davidmpye/EvokeFlowDisplay/pcb/nt7538/fab/bom.csv

Comment | Designator | Footprint | LCSC | LCSC
1uF | C1,C10,C11,C14,C15,C16,C17,C18,C19 | Capacitor_SMD:C_0805_2012Metric |  | C28323
4.7uF | C13 | Capacitor_SMD:C_0805_2012Metric |  | C1779
10uF | C2 | Capacitor_Tantalum_SMD:CP_EIA-3216-18_Kemet-A |  | C7171
C | C3,C4 | Capacitor_SMD:C_0805_2012Metric |  | C49678
100nF | C9,C5,C6,C7,C8,C12 | Capacitor_SMD:C_0805_2012Metric |  | C49678
CN101 | INPUT_CONN1 | Connector_FFC-FPC:Molex_200528-0080_1x08-1MP_P1.00mm_Horizontal
Conn_01x03_Male | J1 | Connector_PinHeader_2.54mm:PinHeader_1x03_P2.54mm_Vertical
BACKLIGHT_CONN | J2 | Connector_JST:JST_PH_S2B-PH-SM4-TB_1x02-1MP_P2.00mm_Horizontal
SUPP_PWR | J3 | Connector_PinHeader_2.54mm:PinHeader_1x02_P2.54mm_Vertical
Conn_01x30 | LCD_CONN1 | Connector_FFC-FPC:Hirose_FH12-30S-0.5SH_1x30-1MP_P0.50mm_Horizontal
Q_NMOS_GSD | Q1 | Package_TO_SOT_SMD:SOT-23 |  | C347475
10K | R1,R3 | Resistor_SMD:R_0805_2012Metric |  | C17414
1K | R2 | Resistor_SMD:R_0805_2012Metric |  | C17513
200K | R4 | Resistor_SMD:R_0805_2012Metric |  | C17539
Conn_01x05 | ST_LINK1 | Connector_PinHeader_2.54mm:PinHeader_1x05_P2.54mm_Vertical
TestPoint | TP1,TP2,TP3,TP4,TP5,TP6,TP7,TP8 | TestPoint:TestPoint_Pad_D1.0mm
GD32E230C8T6 | U1 | Package_QFP:LQFP-48_7x7mm_P0.5mm |  | C380535
100K | VR_CONTRAST1 | Potentiometer_THT:Potentiometer_Vishay_T73YP_Vertical
