davidmpye/EvokeFlowDisplay/pcb/ssd1325/fab/evoke.csv

Comment | Designator | Footprint | LCSC | LCSC
4.7uF | C1 | Capacitor_Tantalum_SMD:CP_EIA-36-18_Kemet-A |  | C118249
10uF | C11 | Capacitor_SMD:C_0805_2012Metric |  | C15850
4.7uF | C13 | Capacitor_SMD:C_0805_2012Metric |  | C1779
10uF | C2 | Capacitor_Tantalum_SMD:CP_EIA-3216-18_Kemet-A |  | C7171
C | C3,C4 | Capacitor_SMD:C_0805_2012Metric |  | C49678
100nF | C9,C5,C6,C7,C8,C10,C12 | Capacitor_SMD:C_0805_2012Metric |  | C49678
CN101 | INPUT_CONN1 | Connector_FFC-FPC:Molex_200528-0080_1x08-1MP_P1.00mm_Horizontal
Conn_01x03_Male | J1 | Connector_PinHeader_2.54mm:PinHeader_1x03_P2.54mm_Vertical
Conn_01x30 | LCD_CONN1 | Connector_FFC-FPC:Hirose_FH12-30S-0.5SH_1x30-1MP_P0.50mm_Horizontal
10K | R1,R3 | Resistor_SMD:R_0805_2012Metric |  | C17414
1.2M | R2 | Resistor_SMD:R_0805_2012Metric |  | C17380
Conn_01x05 | ST_LINK1 | Connector_PinHeader_2.54mm:PinHeader_1x05_P2.54mm_Vertical
TestPoint | TP1,TP2,TP3,TP4,TP5,TP6,TP7,TP8,TP9,TP10,TP11 | TestPoint:TestPoint_Pad_D1.0mm
GD32E230C8T6 | U1 | Package_QFP:LQFP-48_7x7mm_P0.5mm |  | C380535
