davidmpye/EvokeFlowDisplay/lcd_frame/main_bracket.stl

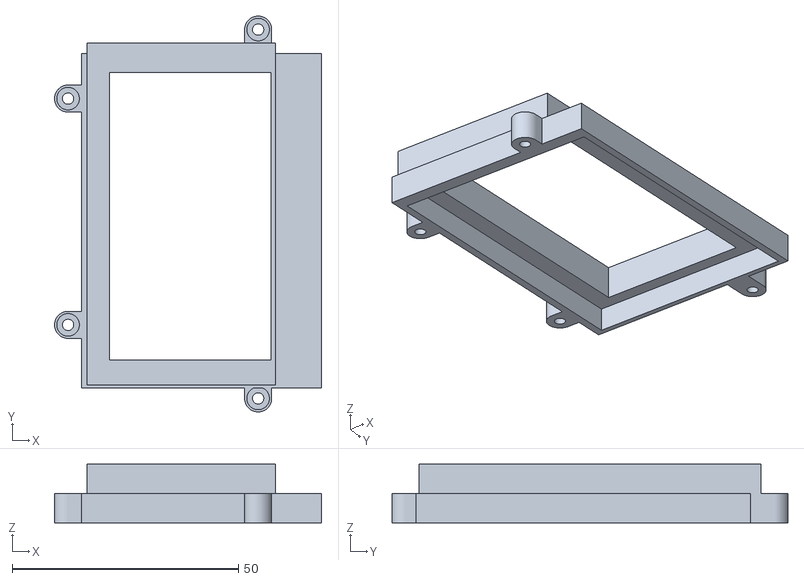
[picture p1: CAD file, 2022-07-04]
lcd_frame/main_bracket.stl
59.0 x 87.5 x 13.0
