davidmpye/EvokeFlowDisplay/lcd_frame/avanti/avanti_lcd_parts.3mf

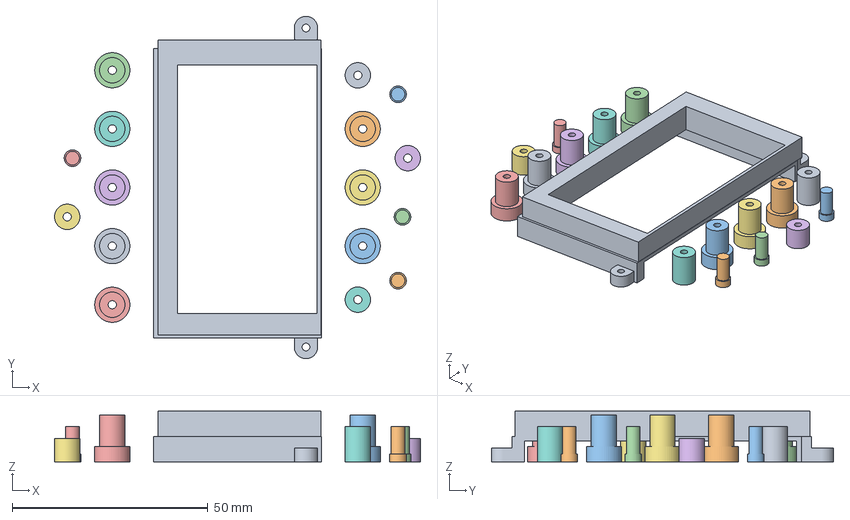
[picture p2: CAD file, 2022-05-02]
lcd_frame/avanti/avanti_lcd_parts.3mf
93.5 x 87.5 x 13.0 mm
avantibracket.stl
button_extx4.stl
collared_standoff_9mmx8.stl
standoff_6mmx2.stl
standoff_9mmx2.stl
