davidmpye/EvokeFlowDisplay/lcd_frame/avanti/collared_standoff_9mmx8.stl

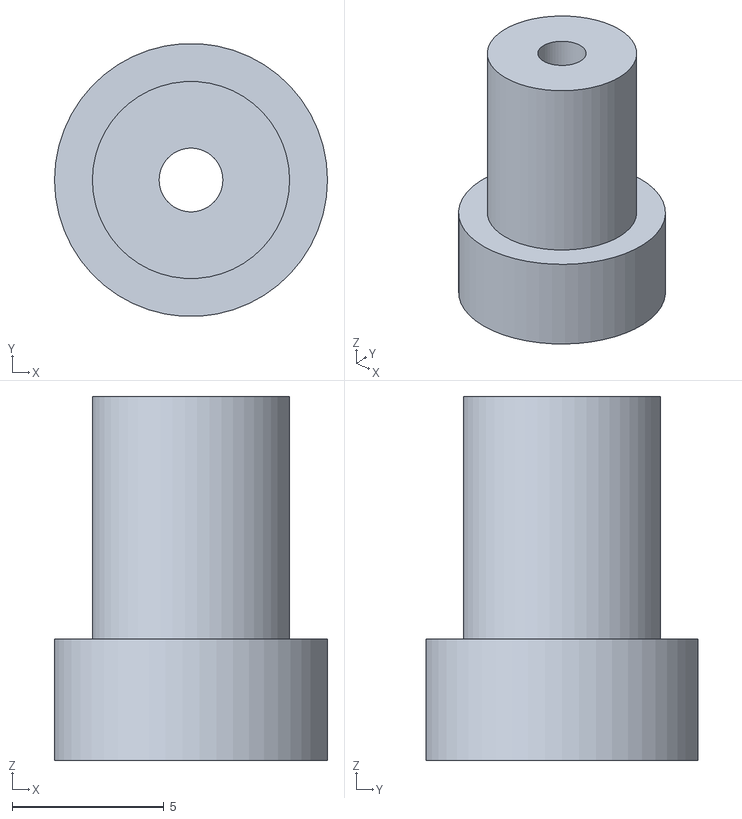
[picture p3: CAD file, 2022-05-02]
lcd_frame/avanti/collared_standoff_9mmx8.stl
9.00 x 8.98 x 12.0
