davidmpye/EvokeFlowDisplay/lcd_frame/avanti/avantibracket.stl

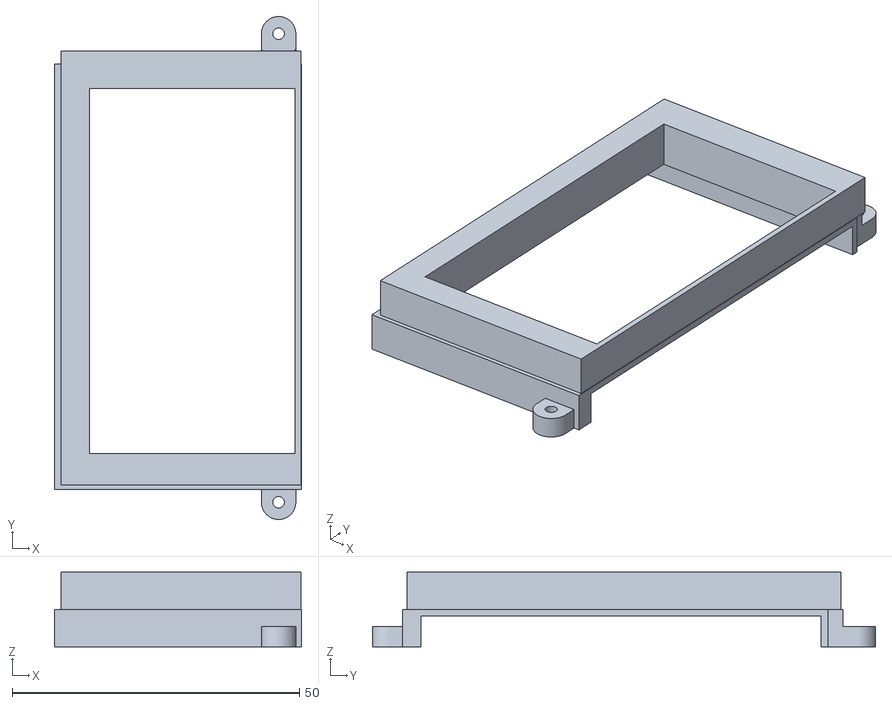
[picture p4: CAD file, 2022-05-02]
lcd_frame/avanti/avantibracket.stl
43.0 x 87.5 x 13.0
