davidmpye/EvokeFlowDisplay/lcd_frame/f4_bracket.stl

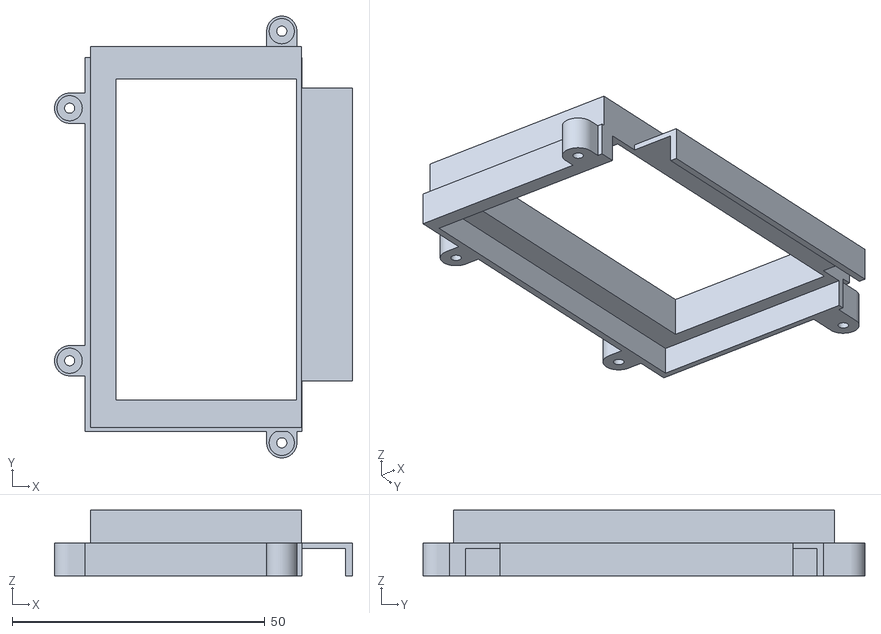
[picture p5: CAD file, 2022-04-24]
lcd_frame/f4_bracket.stl
59.0 x 87.5 x 13.0
