davidmpye/EvokeFlowDisplay/lcd_frame/avanti/standoff_6mmx2.stl

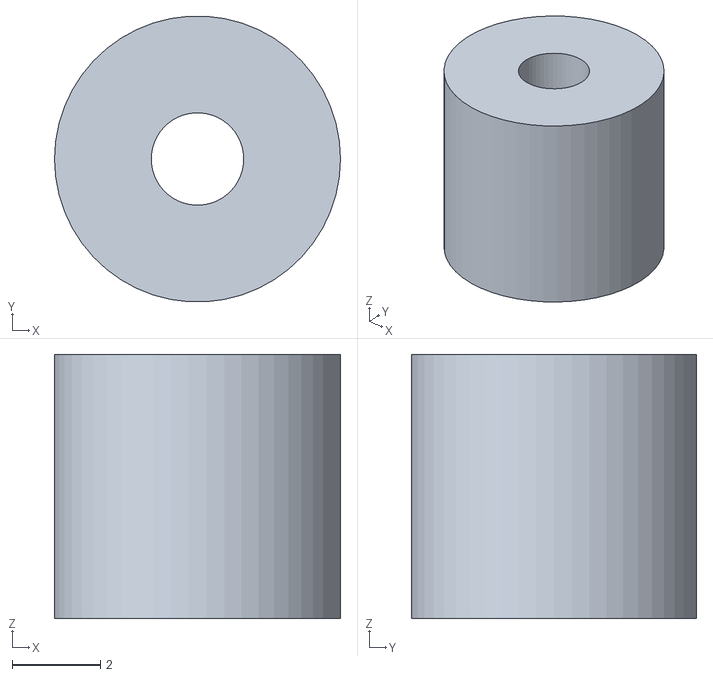
[picture p6: CAD file, 2022-05-02]
lcd_frame/avanti/standoff_6mmx2.stl
6.50 x 6.49 x 6.00
