davidmpye/EvokeFlowDisplay/lcd_frame/avanti/button_extx4.stl

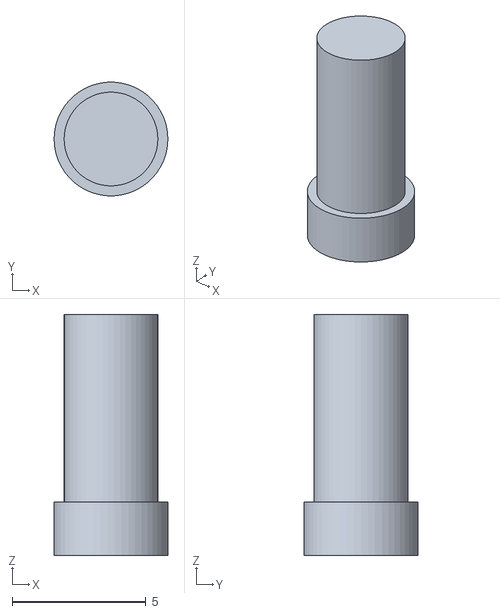
[picture p7: CAD file, 2022-05-02]
lcd_frame/avanti/button_extx4.stl
4.25 x 4.24 x 9.00
