davidmpye/EvokeFlowDisplay/lcd_frame/avanti/standoff_9mmx2.stl

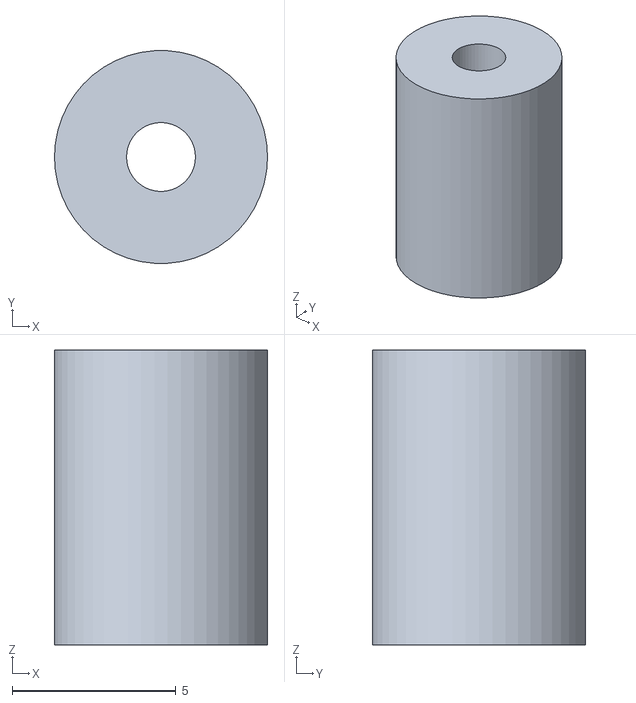
[picture p8: CAD file, 2022-05-02]
lcd_frame/avanti/standoff_9mmx2.stl
6.50 x 6.49 x 9.00
