davidmpye/EvokeFlowDisplay/(list of files, cad)

Other CAD files:
lcd_frame/bracket.3mf
lcd_frame/avanti/avantibracket.scad
