davidmpye/EvokeFlowDisplay/instructions/LCD/PurePackingSlipLCD.odt

Hi!

Thank you for purchasing this LCD upgrade kit for the Pure Evoke Flow radio.

Fitting instructions can be downloaded from:
http://www.davidmpye. (http://www.davidmpye.com/files/LCDInstructions.pdf)com/files/ (http://www.davidmpye.com/files/LCDInstructions.pdf)LCDInstructions.pdf (http://www.davidmpye.com/files/LCDInstructions.pdf)

(please note the capital letters in the link are important)

Please note: The attached four screws should be used to secure the circuit board/the included plastic bracket – they are just the right length)

davidmpye@gmail.com

David Pye

Hi!

Thank you for purchasing this LCD upgrade kit for the Pure Evoke Flow radio.

Fitting instructions can be downloaded from:
http://www.davidmpye. (http://www.davidmpye.com/files/LCDInstructions.pdf)com/files/ (http://www.davidmpye.com/files/LCDInstructions.pdf)LCDInstructions.pdf (http://www.davidmpye.com/files/LCDInstructions.pdf)

(please note the capital letters in the link are important)

Please note: The attached four screws should be used to secure the circuit board/the included plastic bracket – they are just the right length)

davidmpye@gmail.com

David Pye

Hi!

Thank you for purchasing this LCD upgrade kit for the Pure Evoke Flow radio.

Fitting instructions can be downloaded from:
http://www.davidmpye. (http://www.davidmpye.com/files/LCDInstructions.pdf)com/files/ (http://www.davidmpye.com/files/LCDInstructions.pdf)LCDInstructions.pdf (http://www.davidmpye.com/files/LCDInstructions.pdf)

(please note the capital letters in the link are important)

Please note: The attached four screws should be used to secure the circuit board/the included plastic bracket – they are just the right length)

davidmpye@gmail.com

David Pye

Hi!

Thank you for purchasing this LCD upgrade kit for the Pure Evoke Flow radio.

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

(please note the capital letters in the link are important)

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

davidmpye@gmail.com

David Pye
