davidmpye/EvokeFlowDisplay/instructions/OLED/PurePackingSlipOLED25b.odt

Hi!

Thank you for purchasing this OLED replacement kit for the Pure Evoke Flow radio.

Fitting instructions can be downloaded from:
http://www.davidmpye. (http://www.davidmpye.com/files/oled25.pdf)com/files/oled25 (http://www.davidmpye.com/files/oled25.pdf)b (http://www.davidmpye.com/files/oled25.pdf).pdf (http://www.davidmpye.com/files/oled25.pdf)

Please note: If you have fitted one of these kits before, the installation instructions have changed. Please check the instructions.

The attached two screws should be used to secure the circuit board in the kit to the screen bracket, instead of the original screws, as they are slightly longer.

davidmpye@gmail.com

David Pye

Hi!

Thank you for purchasing this OLED replacement kit for the Pure Evoke Flow radio.

Fitting instructions can be downloaded from:
http://www.davidmpye. (http://www.davidmpye.com/files/oled25b.pdf)com/files/oled25 (http://www.davidmpye.com/files/oled25b.pdf)b (http://www.davidmpye.com/files/oled25b.pdf).pdf (http://www.davidmpye.com/files/oled25b.pdf)

Please note: If you have fitted one of these kits before, the installation instructions have changed. Please check the instructions.

The attached two screws should be used to secure the circuit board in the kit to the screen bracket, instead of the original screws, as they are slightly longer.

davidmpye@gmail.com

David Pye

Hi!

Thank you for purchasing this OLED replacement kit for the Pure Evoke Flow radio.

Fitting instructions can be downloaded from:
http://www.davidmpye. (http://www.davidmpye.com/files/oled25.pdf)com/files/oled25 (http://www.davidmpye.com/files/oled25.pdf)b (http://www.davidmpye.com/files/oled25.pdf).pdf (http://www.davidmpye.com/files/oled25.pdf)

Please note: If you have fitted one of these kits before, the installation instructions have changed. Please check the instructions.

The attached two screws should be used to secure the circuit board in the kit to the screen bracket, instead of the original screws, as they are slightly longer.

davidmpye@gmail.com

David Pye
