davidmpye/EvokeFlowDisplay/pcb/ssd1325/evoke.kicad_pcb

## KiCad design pcb/ssd1325/evoke.kicad_pcb (2021-06-09)

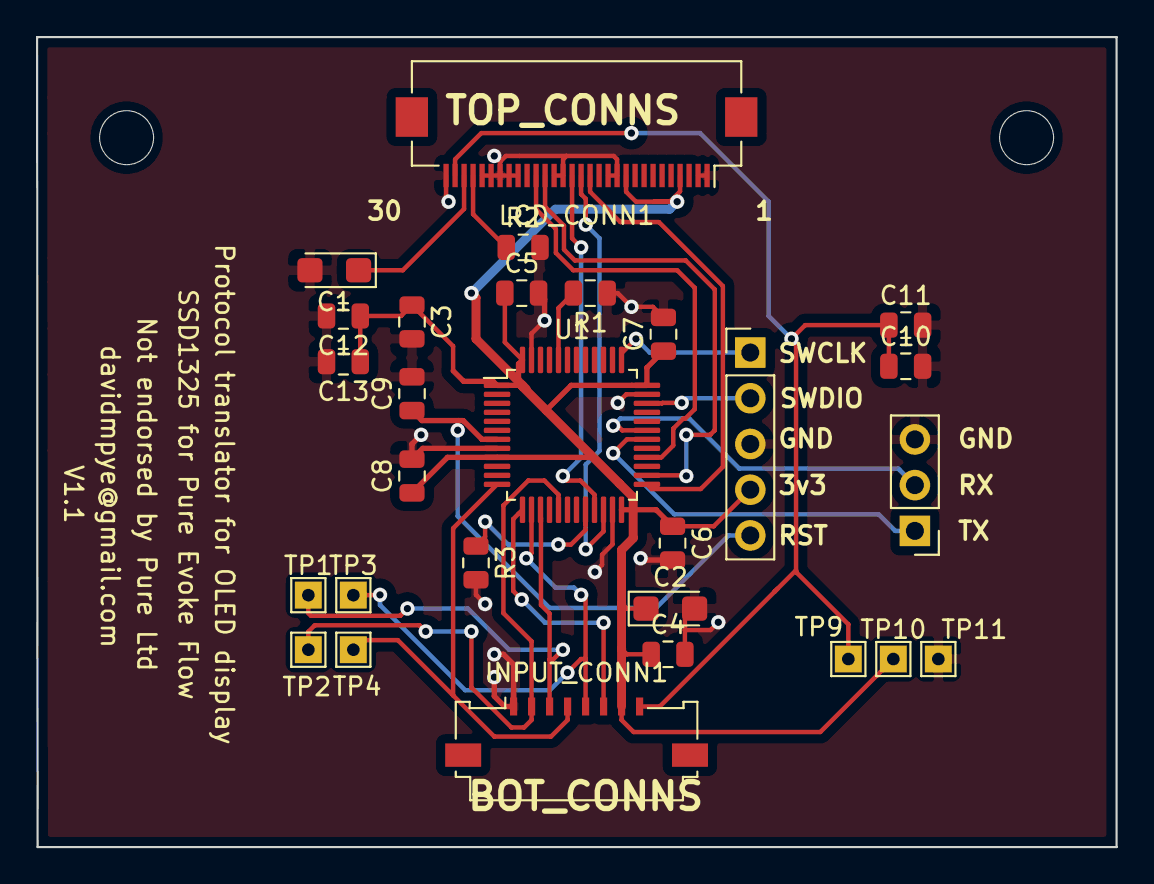
[picture p43: board pcb/ssd1325/evoke.kicad_pcb from above]

Board: 2 copper layers, 60.0 x 45.0 mm, 28 parts (0 on the bottom side), 22 nets.

Parts:
C1: 4.7uF; CP_EIA-3216-18_Kemet-A
C2: 10uF; CP_EIA-3216-18_Kemet-A
C3, C4: C; C_0805_2012Metric
C5, C6, C7, C8, C9, C10, C12: 100nF; C_0805_2012Metric
C11: 10uF; C_0805_2012Metric
C13: 4.7uF; C_0805_2012Metric
INPUT_CONN1: CN101; Molex_200528-0080_1x08-1MP_P1.00mm_Horizontal
J1: Conn_01x03_Male; PinHeader_1x03_P2.54mm_Vertical
LCD_CONN1: Conn_01x30; Hirose_FH12-30S-0.5SH_1x30-1MP_P0.50mm_Horizontal
R1, R3: 10K; R_0805_2012Metric
R2: 1.2M; R_0805_2012Metric
ST_LINK1: Conn_01x05; PinHeader_1x05_P2.54mm_Vertical
TP1, TP2, TP3, TP4, TP9, TP10, TP11: TestPoint; TestPoint_THTPad_1.5x1.5mm_Drill0.7mm
U1: STM32F103C8Tx; LQFP-48_7x7mm_P0.5mm

Connections:
+3V3: C2.1, C3.1, C4.1, C5.1, C6.1, C7.1, C8.1, C12.1, C13.1, INPUT_CONN1.7, LCD_CONN1.4, LCD_CONN1.10, ST_LINK1.4, TP10.1, U1.1, U1.9, U1.24, U1.36, U1.48
CS_IN: INPUT_CONN1.5, TP3.1, U1.14
D_C_IN: INPUT_CONN1.4, TP4.1, U1.12
GND: C1.2, C2.2, C3.2, C4.2, C5.2, C6.2, C7.2, C8.2, C9.2, C10.2, C11.2, C12.2, C13.2, INPUT_CONN1.1, J1.3, LCD_CONN1.1, LCD_CONN1.2, LCD_CONN1.11, LCD_CONN1.12, LCD_CONN1.17, LCD_CONN1.18, LCD_CONN1.22, LCD_CONN1.23, LCD_CONN1.24, LCD_CONN1.25, LCD_CONN1.26, LCD_CONN1.30, R1.1, R2.2, R3.2, ST_LINK1.3, TP11.1, U1.8, U1.23, U1.35, U1.47
LCD_CS: LCD_CONN1.14, U1.25
LCD_DATA: LCD_CONN1.20, U1.28
LCD_D_C: LCD_CONN1.16, U1.21
LCD_RST: LCD_CONN1.15, U1.22
LCD_SCK: LCD_CONN1.19, U1.26
unnamed: C1.1, LCD_CONN1.28
unnamed: LCD_CONN1.27, R2.1
unnamed: R1.2, U1.44
unnamed: R3.1, U1.20
RESET: C9.1, ST_LINK1.5, U1.7
RST_IN: INPUT_CONN1.6, U1.13
SCK_IN: INPUT_CONN1.3, TP1.1, U1.15
SDIN_IN: INPUT_CONN1.2, TP2.1, U1.17
SWCLK: ST_LINK1.1, U1.37
SWDIO: ST_LINK1.2, U1.34
USART1_RX: J1.2, U1.31
USART1_TX: J1.1, U1.30
VCC: C10.1, C11.1, INPUT_CONN1.8, LCD_CONN1.29, TP9.1
