davidmpye/EvokeFlowDisplay/pcb/nt7538/evoke.kicad_pcb

## KiCad design pcb/nt7538/evoke.kicad_pcb (2020-08-15, an earlier design)

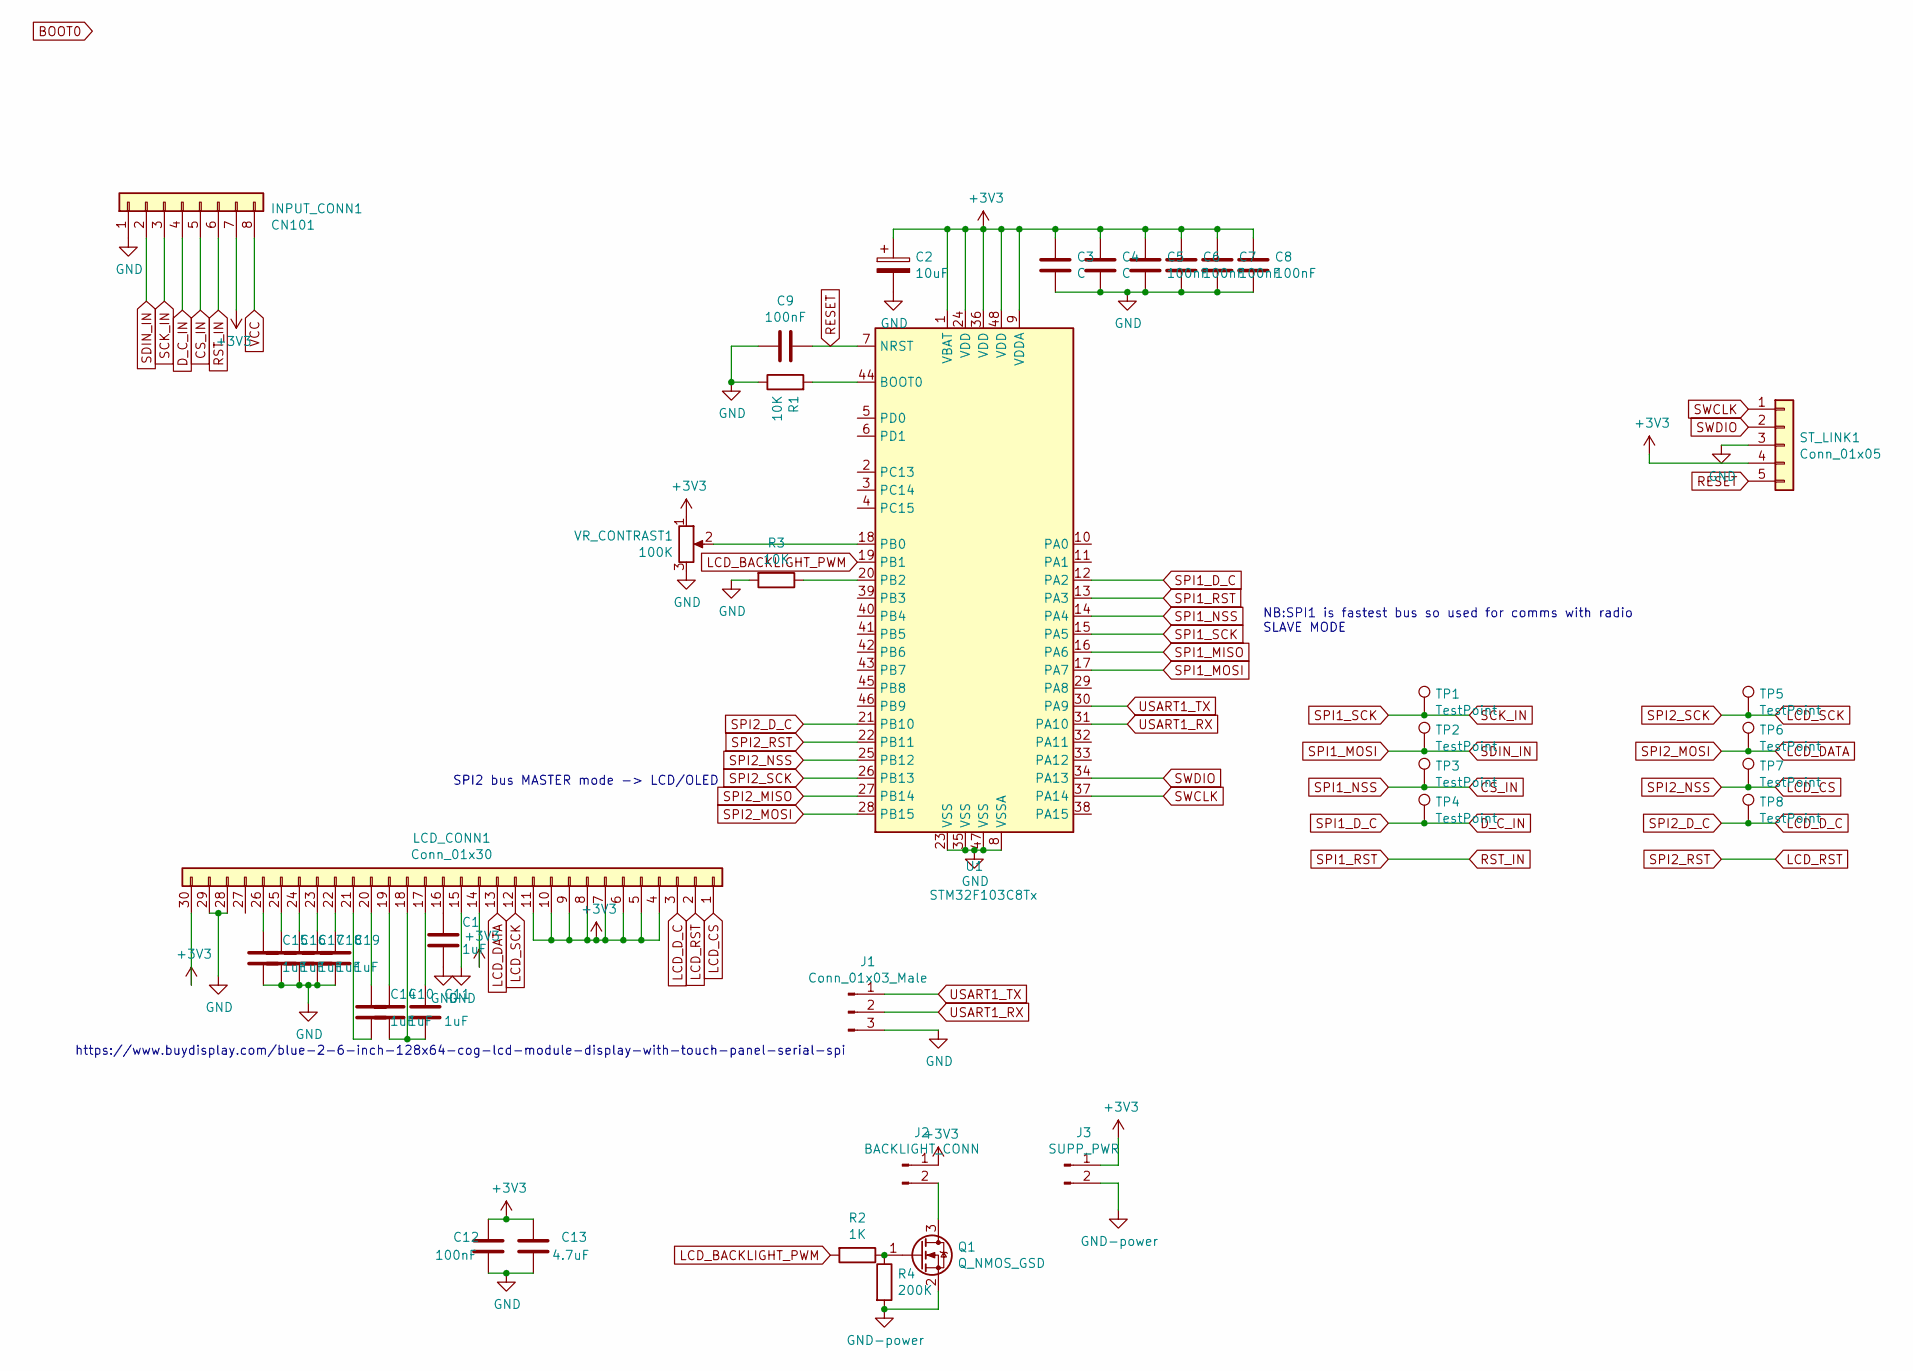
[picture p44: schematic evoke.sch]

Parts:
C1, C10, C11, C14, C15, C16, C17, C18, C19: 1uF; C_0805_2012Metric; LCSC C28323
C2: 10uF; CP_EIA-3216-18_Kemet-A; LCSC C7171
C3, C4: C; C_0805_2012Metric; LCSC C49678
C5, C6, C7, C8, C9, C12: 100nF; C_0805_2012Metric; LCSC C49678
C13: 4.7uF; C_0805_2012Metric; LCSC C1779
INPUT_CONN1: CN101; Molex_200528-0080_1x08-1MP_P1.00mm_Horizontal
J1: Conn_01x03_Male; PinHeader_1x03_P2.54mm_Vertical
J2: BACKLIGHT_CONN; JST_PH_S2B-PH-SM4-TB_1x02-1MP_P2.00mm_Horizontal
J3: SUPP_PWR; PinHeader_1x02_P2.54mm_Vertical
LCD_CONN1: Conn_01x30; Hirose_FH12-30S-0.5SH_1x30-1MP_P0.50mm_Horizontal
Q1: Q_NMOS_GSD; SOT-23; LCSC C347475
R1, R3: 10K; R_0805_2012Metric; LCSC C17414
R2: 1K; R_0805_2012Metric; LCSC C17513
R4: 200K; R_0805_2012Metric; LCSC C17539
ST_LINK1: Conn_01x05; PinHeader_1x05_P2.54mm_Vertical
TP1, TP2, TP3, TP4, TP5, TP6, TP7, TP8: TestPoint; TestPoint_Pad_D1.0mm
U1: STM32F103C8Tx; LQFP-48_7x7mm_P0.5mm; LCSC C8734
VR_CONTRAST1: 100K; Potentiometer_Vishay_T73YP_Vertical

Connections:
+3V3: C2.1, C3.1, C4.1, C5.1, C6.1, C7.1, C8.1, C12.1, C13.1, INPUT_CONN1.7, J2.1, J3.1, LCD_CONN1.4, LCD_CONN1.5, LCD_CONN1.6, LCD_CONN1.7, LCD_CONN1.8, LCD_CONN1.9, LCD_CONN1.10, LCD_CONN1.11, LCD_CONN1.14, LCD_CONN1.30, ST_LINK1.4, U1.1 (VBAT), U1.9 (VDDA), U1.24 (VDD), U1.36 (VDD), U1.48 (VDD), VR_CONTRAST1.1; also elsewhere on the board
CS_IN: INPUT_CONN1.5, TP3.1, U1.14 (PA4); also elsewhere on the board
D_C_IN: INPUT_CONN1.4, TP4.1, U1.12 (PA2); also elsewhere on the board
LCD_BACKLIGHT_PWM: R2.2, U1.19 (PB1)
LCD_CS: LCD_CONN1.1, TP7.1, U1.25 (PB12); also elsewhere on the board
LCD_DATA: LCD_CONN1.13, TP6.1, U1.28 (PB15); also elsewhere on the board
LCD_D_C: LCD_CONN1.3, TP8.1, U1.21 (PB10); also elsewhere on the board
LCD_RST: LCD_CONN1.2, U1.22 (PB11); also elsewhere on the board
LCD_SCK: LCD_CONN1.12, TP5.1, U1.26 (PB13); also elsewhere on the board
unnamed 9: C1.1, LCD_CONN1.16; also elsewhere on the board
unnamed 10: C10.1, LCD_CONN1.19; also elsewhere on the board
unnamed 11: C10.2, C11.2, LCD_CONN1.18; also elsewhere on the board
unnamed 12: C11.1, LCD_CONN1.17; also elsewhere on the board
unnamed 13: C14.1, LCD_CONN1.20; also elsewhere on the board
unnamed 14: C14.2, LCD_CONN1.21; also elsewhere on the board
unnamed 15: C15.1, LCD_CONN1.26; also elsewhere on the board
unnamed 16: C16.1, LCD_CONN1.25; also elsewhere on the board
unnamed 17: C17.1, LCD_CONN1.24; also elsewhere on the board
unnamed 18: C18.1, LCD_CONN1.23; also elsewhere on the board
unnamed 19: C19.1, LCD_CONN1.22; also elsewhere on the board
unnamed: J2.2, Q1.3 (D)
unnamed: Q1.1 (G), R2.1, R4.1
unnamed: R1.2, U1.44 (BOOT0)
unnamed: R3.1, U1.20 (PB2)
unnamed 32: U1.18 (PB0), VR_CONTRAST1.2; also elsewhere on the board
RESET: C9.1, ST_LINK1.5, U1.7 (NRST)
RST_IN: INPUT_CONN1.6, U1.13 (PA3); also elsewhere on the board
SCK_IN: INPUT_CONN1.3, TP1.1, U1.15 (PA5); also elsewhere on the board
SDIN_IN: INPUT_CONN1.2, TP2.1, U1.17 (PA7); also elsewhere on the board
SPI1_MISO: U1.16 (PA6)
SPI2_MISO: U1.27 (PB14)
SWCLK: ST_LINK1.1, U1.37 (PA14)
SWDIO: ST_LINK1.2, U1.34 (PA13)
USART1_RX: J1.2, U1.31 (PA10)
USART1_TX: J1.1, U1.30 (PA9)

Notes on the sheet:
NB:SPI1 is fastest bus so used for comms with radio SLAVE MODE
SPI2 bus MASTER mode -> LCD/OLED
https://www.buydisplay.com/blue-2-6-inch-128x64-cog-lcd-module-display-with-touch-panel-serial-spi

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
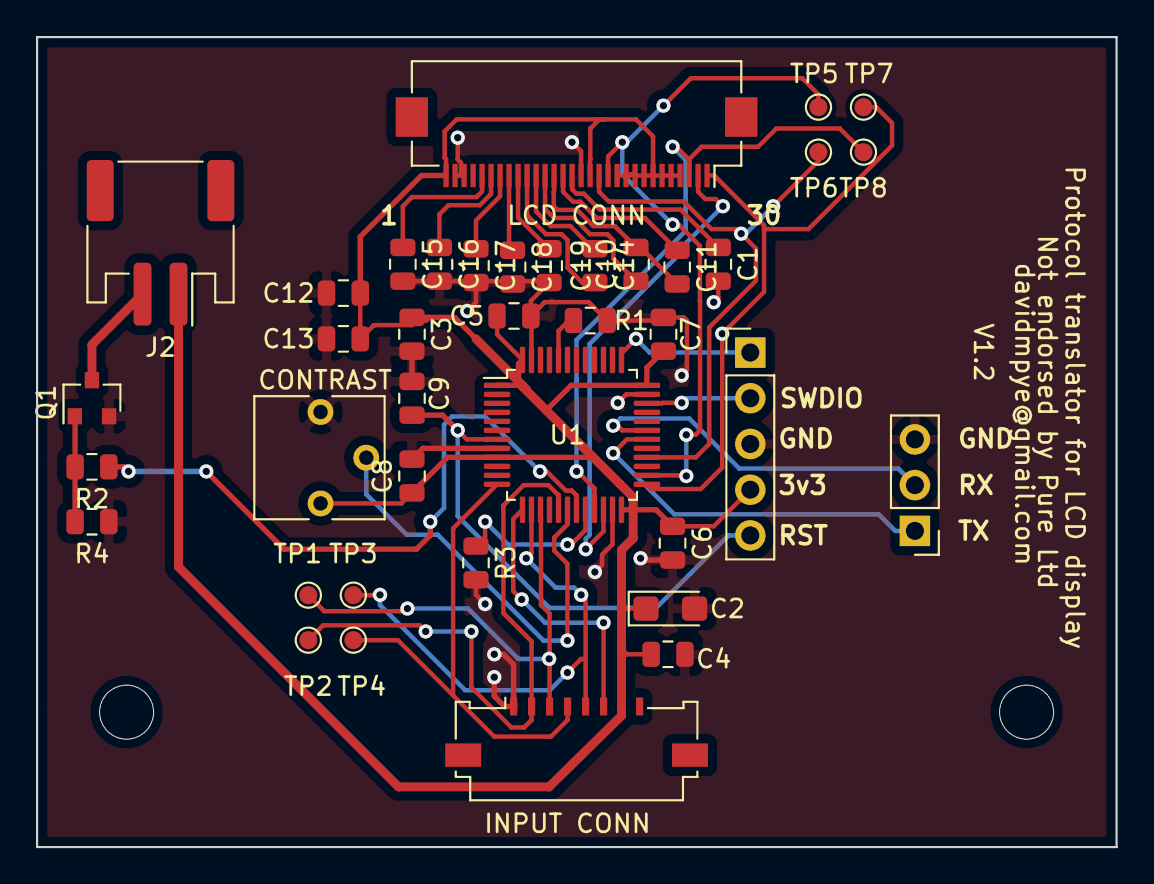
[picture p45: board pcb/nt7538/evoke.kicad_pcb from above]

Board: 2 copper layers, 60.0 x 45.0 mm, 39 parts (0 on the bottom side), 34 nets.

Other parts of the board:
CONTRAST: 100K; Potentiometer_Vishay_T73YP_Vertical
INPUT CONN: CN101; Molex_200528-0080_1x08-1MP_P1.00mm_Horizontal
LCD CONN: Conn_01x30; Hirose_FH12-30S-0.5SH_1x30-1MP_P0.50mm_Horizontal

Their connections:
+3V3: CONTRAST.1, INPUT CONN.7, LCD CONN.4, LCD CONN.5, LCD CONN.6, LCD CONN.7, LCD CONN.8, LCD CONN.9, LCD CONN.10, LCD CONN.11, LCD CONN.14, LCD CONN.30; also elsewhere on the board
CS_IN: INPUT CONN.5; also elsewhere on the board
D_C_IN: INPUT CONN.4; also elsewhere on the board
LCD_CS: LCD CONN.1; also elsewhere on the board
LCD_DATA: LCD CONN.13; also elsewhere on the board
LCD_D_C: LCD CONN.3; also elsewhere on the board
LCD_RST: LCD CONN.2; also elsewhere on the board
LCD_SCK: LCD CONN.12; also elsewhere on the board
unnamed 9: LCD CONN.16; also elsewhere on the board
unnamed 10: LCD CONN.19; also elsewhere on the board
unnamed 11: LCD CONN.18; also elsewhere on the board
unnamed 12: LCD CONN.17; also elsewhere on the board
unnamed 13: LCD CONN.20; also elsewhere on the board
unnamed 14: LCD CONN.21; also elsewhere on the board
unnamed 15: LCD CONN.26; also elsewhere on the board
unnamed 16: LCD CONN.25; also elsewhere on the board
unnamed 17: LCD CONN.24; also elsewhere on the board
unnamed 18: LCD CONN.23; also elsewhere on the board
unnamed 19: LCD CONN.22; also elsewhere on the board
unnamed 32: CONTRAST.2; also elsewhere on the board
RST_IN: INPUT CONN.6; also elsewhere on the board
SCK_IN: INPUT CONN.3; also elsewhere on the board
SDIN_IN: INPUT CONN.2; also elsewhere on the board
