davidmpye/EvokeFlowDisplay/code/ssd1305.c

/*
# Copyright (C) 2020 David Pye davidmpye@gmail.com
# This file is part of the OLED compatibility project targetted at
# Pure Radios Evoke Flow models
#
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
# You should have received a copy of the GNU General Public License
# along with this project.  If not, see <http://www.gnu.org/licenses/>.
*/

#include "ssd1305.h"

#define SSD1305_INIT_CMD_LEN 30
//This is our default block of 'init commands'
uint8_t SSD1305_init_cmds [] = {
	0xAE,   //Display OFF
	0xD5,	//Display clock
	0xF0,	//Display clock oscillator freq
	0xA8,	//Multiplex ratio
	0x3F, 	//Multiplex radio arg
	0xD3,	//Display offset 
	0x40,	//vertical offset//
	0xad,   //External VCC supply (default anyway!)
	0x8e,   //Mandatory (but unspecified) argument to 0xAD!
	0xd8,	//Area colour mode
	0x05,   //monochrome, low power display mode
#ifdef VERTFLIP 
	0xa1,
	0xc8,
#else
	0xa0,
	0xc0, // Change this to c8 if horizontal flip only needed
#endif
	0xda, 	//Hardware com pin configuration
	0x12, 	//'alternative' com pin config, no left to right remap.
	0x91, 	//current drive pulse width
	0x3f, 	//args to above
	0x3f,	//args to above
	0x3f,	//args to above
	0x3f,	//args to above
	0x82,	//Set brightness
	0x80,   //Default brightness
	0xd9,   //Set precharge period
	0xf1,   //was f1 //F = phase 1, 1= phase 2 - 3f is dimmer, but acceptably so
	0xdb,   //VComH select
	0x34,   //0.77x VCC (Default)
	0xa6,   //Normal, non inverted display
	0xa4,   //Display ALL on 0xa5, - 'follows RAM' - ie normal 0xa4
	//if we wanted to use horizontal addressing mode, we'd add:
        //0x20, 0x00,
        //default is page addressing mode, which is 0x22
	0xAF,   //Display on
};

#define CMDBLOCK_LEN 7
#define BRIGHTNESS_81_OFFSET 1
#define BRIGHTNESS_DB_OFFSET 3
#define PRECHARGE_OFFSET 5
#define DISPLAY_STATE_OFFSET 6
uint8_t SSD1305_cmdBlock[] = {
	0x81, //brightness
	0xB0, //full
	0xDB, //brightness
	0xC3, //full,
	0xD9, //precharge
	0xF1, //normal brightness
	0xAF, //display state
};

void SSD1305_init() {
    //CS high
    gpio_set(OUT_GPIO, OUT_CS_PIN);
    
    //command mode
    gpio_clear(OUT_GPIO, OUT_D_C_PIN);

    // Toggle reset 
    gpio_set(OUT_GPIO, OUT_RST_PIN);
    for (int i=0; i<1000; ++i) __asm__("NOP");
    gpio_clear(OUT_GPIO, OUT_RST_PIN);
    for (int i=0; i<1000; ++i) __asm__("NOP");
    gpio_set(OUT_GPIO, OUT_RST_PIN);
    
    // Post reset pause
    for (int i=0; i<5000; ++i) __asm__("NOP");
    // Send the init string   
    for (int i=0; i<SSD1305_INIT_CMD_LEN; ++i)  {
    	SSD1305_sendByte(true, SSD1305_init_cmds[i]);
    }
}

void SSD1305_sendByte(bool cmd, uint8_t b) {
    	//CS low
	gpio_clear(GPIOB, OUT_CS_PIN);
	
	//Set data/command pin state
	if (cmd) 
        gpio_clear(GPIOB, OUT_D_C_PIN);
	else 
        gpio_set(GPIOB, OUT_D_C_PIN);
	
	for (int i=0; i<10; ++i) __asm__("NOP");

	spi_send(SPI2, b);

    while (!(SPI_SR(SPI2) & SPI_SR_TXE)) {
		//Wait for transfer to start
	}

	while ((SPI_SR(SPI2) & SPI_SR_BSY)) {
		//Wait fof transfer to finish
	}
	for (int i=0; i<10; ++i) __asm__("NOP");

	//CS_high - end of byte
	gpio_set(GPIOB, OUT_CS_PIN);
}

void SSD1305_setBrightness(uint8_t brightness) {
	//ValA = 0x81 arg, valB = 0xDB arg
    	//Data captured from radio's own 'brighness' values.
	uint8_t valA, valB;
	switch (brightness) {
		case 1:
			valA = 0x00;
			valB = 0x00;
			SSD1305_cmdBlock[PRECHARGE_OFFSET] = 0x31;
			break;
		case 2:
			valA = 0x00;
			valB = 0x08;
			SSD1305_cmdBlock[PRECHARGE_OFFSET] = 0x31;
			break;
		case 3:
			valA = 0x10;
			valB = 0x0C;
			SSD1305_cmdBlock[PRECHARGE_OFFSET] = 0x51;
			break;
		case 4:
			valA = 0x20;
			valB = 0x0C;
			SSD1305_cmdBlock[PRECHARGE_OFFSET] = 0x81;	
			break;
		case 5:
			valA = 0x30;
			valB = 0x24;
			SSD1305_cmdBlock[PRECHARGE_OFFSET] = 0xA1;	
			break;
		case 6:
			valA = 0x40;
			valB = 0x24;
			SSD1305_cmdBlock[PRECHARGE_OFFSET] = 0xF1;	
			break;
		case 7:
			valA = 0x50;
			valB = 0x2C;
			SSD1305_cmdBlock[PRECHARGE_OFFSET] = 0xF1;	
			break;
		case 8:
			valA = 0x70;
			valB = 0x34;
			SSD1305_cmdBlock[PRECHARGE_OFFSET] = 0xF1;	
			break;
		case 9:
			valA = 0x80;
			valB = 0x34;
			SSD1305_cmdBlock[PRECHARGE_OFFSET] = 0xF1;	
			break;
		case 10:
		default:
			valA = 0xB0;
			valB = 0x3C;
			SSD1305_cmdBlock[PRECHARGE_OFFSET] = 0xF1;	
			break;
	}
	SSD1305_cmdBlock[BRIGHTNESS_81_OFFSET] = valA;
	SSD1305_cmdBlock[BRIGHTNESS_DB_OFFSET] = valB;
}

void SSD1305_enableDisplay(bool state) {
    if (state) {
		SSD1305_cmdBlock[DISPLAY_STATE_OFFSET] = 0xAF;
	}
	else {
		SSD1305_cmdBlock[DISPLAY_STATE_OFFSET] = 0xAE;
	}
}

void SSD1305_sendPage(uint8_t page, volatile uint8_t *fb) {
	SSD1305_sendByte(true, 0xB0 + page); //set page
	SSD1305_sendByte(true, 0x00); //set column offset lower  - 0 
	SSD1305_sendByte(true, 0x10); //set column offset higher - 0 
		
	for (int i=0; i<128; ++i) {
		SSD1305_sendByte(false, fb[(page*128) + i]);
	}
} 

void SSD1305_sendFB(volatile uint8_t *fb) {
    for (int i=0; i<8; ++i) 
        SSD1305_sendPage(i, fb);
} 


void SSD1305_preDmaTransfer(uint8_t page) {
	//Send page-select preamble
	SSD1305_sendByte(true, 0xB0 + page); //set page
	SSD1305_sendByte(true, 0x00); //set column offset lower  - 0 
	SSD1305_sendByte(true, 0x10); //set column offset higher - 0 

	//Pull CS low	
	gpio_clear(GPIOB, OUT_CS_PIN);
	
	//Pull data/cmd pin high so the SSD1305 is expecting data
	gpio_set(GPIOB, OUT_D_C_PIN);
}

void SSD1305_postDmaTransfer(uint8_t page) {
	//Nothing page specific here, just pull CS high to signify end of data
	gpio_set(GPIOB, OUT_CS_PIN);
	gpio_clear(GPIOB, OUT_D_C_PIN);
}

void SSD1305_sendCmdBlock() {
 	for (int i=0; i<CMDBLOCK_LEN; ++i)  {
    	SSD1305_sendByte(true, SSD1305_cmdBlock[i]);
 	}
}
