davidmpye/EvokeFlowDisplay/(commit log)

2020-05-01 Initial import of versioning
    [evoke.kicad_pcb, evoke.sch]
2020-05-01 Initial import of the python display 'driver'
2020-05-01 Import of v1.0 jlcpcb manufacture files
    [bom.csv, pickplace-top.csv]
2020-05-03 Squash compiler warnings (mostly by adding function prototypes etc)
2020-05-04 Initial trial of DMA (#define USE_DMA). Not working very well!
    [main.c, ssd1305.c, ssd1305.h]
2020-05-05 Refactoring of how commands work, as if you send commands from interrupt context, it mucks up the datablock that's being sent
2020-05-05 Fix the DMA priority problem, no glitches now
    [main.c, ssd1305.c]
2020-05-05 Just send changed pages via DMA again
2020-05-05 Send the command block even in DMA mode
2020-05-06 Remove the USE_DMA define - it works so well, we'll just use DMA always!
2020-05-06 Documentation for the DMA pre/postamble
2020-05-11 Fix (I think!) for the screen corruption issue on tuning
    [main.c]
2020-05-19 Initial import for NT7538 driver LCD
2020-05-21 Move PCB into subdirectory to allow creation of LCD version
    [evoke.kicad_pcb, evoke.sch]
2020-05-21 Duplication of ssd1305 PCB design to NT7538 layout
    [evoke.kicad_pcb, evoke.sch]
2020-05-21 Add frame for NT7538 LCD from buydisplay.com https://www.buydisplay.com/white-2-6-inch-spi-serial-graphic-touch-screen-lcd-display-128x64-nt7538
    [lcd_frame.scad, lcd_frame.stl]
2020-05-21 Initial draft of backlight PWM control
    [evoke.sch]
2020-05-25 Improve #defines to allow selecting display type and fix ND7538 spell error
    [main.c, nt7538.c]
2020-05-31 Initial changes for LCD support
    [evoke.kicad_pcb, evoke.sch]
2020-06-01 Further evolution of NT schmatic
    [evoke.kicad_pcb]
2020-06-02 Fix bug with pins being wrong on connector, and add USART header
    [evoke.kicad_pcb, evoke.sch]
2020-06-02 Addition of additional components as per jack wan's schematic example
    [evoke.kicad_pcb, evoke.sch]
2020-06-04 Put next revision into manufacture - hopefully ready to go, now with test points!
    [evoke.kicad_pcb, evoke.sch]
2020-06-04 Add fab for SSD1305
    [evoke.csv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]
2020-06-16 Update code to use INTERNAL oscillator so it works without an external crystal
    [main.c]
2020-06-20 Fix to use the same D_C pin as the GPIO on the board
    [main.c]
2020-06-21 Commit of NT version including trimpot
    [evoke.kicad_pcb, evoke.sch]
2020-06-21 More NT7538 tweaks
    [evoke.kicad_pcb]
2020-06-22 NT7538 to manufacture
    [evoke.kicad_pcb, evoke.sch]
2020-06-22 Add fab files
    [evoke.csv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]
2020-06-29 Addition of PWM backlight and contrast POT reading
2020-07-01 Move screw holes for the nt7538 PCB, and increment PCB version number to 1.1
    [evoke.kicad_pcb]
2020-07-04 Add OpenOCD lock files and adjust upload.sh to lock
    [ocd-lock.cfg, ocd-unlock.cfg, stlink-v2.cfg, stm32f1x.cfg]
2020-07-04 Fix - inital brightness to off
    [nt7538.c]
2020-08-03 Change to cheaper (but still 25V rated) tantalum cap for C1
    [evoke.csv]
2020-08-15 add bom
    [bom.csv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]
2020-08-15 Updates to v1.2 for NT pcb - hole spacing redone
    [evoke.csv, evoke.kicad_pcb]
2020-08-15 Add second design of LCD frame
    [lcd_frame_2.scad, lcd_frame_2.stl]
2020-08-15 Add lcd frames sliced gcode
2020-08-16 Tweak to make LCD aperture 0.25mm narrower so it grips more tightly
    [lcd_frame_2.scad, lcd_frame_2.stl]
2020-08-17 Update instructions to use bracket clip
2020-08-17 Redo of bracketry
    [bracket.scad, lcd_frame.scad, lcd_frame.stl, lcd_frame_2.scad, lcd_frame_2.stl, main_bracket.stl, retaining_clip.stl]
2020-08-23 Add pin notes for oasis flow
2020-09-06 Update to version 1.1 of OLED PCB with square THT TP pads
    [evoke.csv, evoke.kicad_pcb, evoke.sch]
2020-11-30 Fix cfgX
    [stm32f1x.cfg]
2020-12-07 Add comment for the horizontal flip option
    [ssd1305.c]
2020-12-26 Add fix for 'not dimming enough' by changing the Phase 2 precharge time
    [ssd1305.c]
2020-12-29 Add new mainbracket gcodes
    [retaining_clip.stl]
2020-12-29 Removal of retaining clip - pointless
    [bracket.scad]
2021-04-20 change to gd32
    [bom.csv, evoke.csv]
2021-06-09 import of 'flipped' ssd1325 pcb
    [evoke.csv, evoke.kicad_pcb, evoke.sch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]
2021-06-11 Fix GD rotatoin
    [evoke-top-pos.csv]
2022-04-24 add f4 option
    [bracket.scad]
2022-04-24 add bracket for f4
    [f4_bracket.stl]
2022-04-25 Add avanti trialbracket
    [avantibracket.scad]
2022-04-26 Updates for standoffs
    [avantibracket.scad]
2022-05-02 add avanti bracket parts
    [avantibracket.scad, avantibracket.stl, button_extx4.stl, collared_standoff_9mmx8.stl, standoff_6mmx2.stl, standoff_9mmx2.stl]
2022-05-02 Add sliced bits
    [avanti_lcd_parts.3mf]
2022-05-02 Change to 40% infill for printed parts
2022-07-04 Adjust hole and aperture size
    [bracket.3mf, bracket.scad, main_bracket.stl]
2022-07-04 Add back the brim
    [bracket.3mf]
2022-07-21 Change to the support material gap for easier separation
    [bracket.3mf]
